troisiemetype/universal_AVR_programmer/components/ISP.ods

Id | Référence | Boîtier | Quantité | Désignation | face | fabricant | référence | fournisseur
21 | C1 | C_0603_1608Metric | 1 | 1u | top | samsung | CL10A105KP8NNWC (https://www.mouser.fr/ProductDetail/187-CL10A105KP8NNWC) | mouser
2 | C4,C2,C3 | C_0603_1608Metric | 3 | 0.1u | top | samsung | CL10B104KA8NNWC (https://www.mouser.fr/ProductDetail/187-CL10B104KA8NNWC) | mouser
10 | D1 | D_SOD-123 | 1 | D | top | OnSemi | MMSD4148T3G (https://www.mouser.fr/ProductDetail/863-MMSD4148T3G) | mouser
20 | D2 | D_SOD-123 | 1 | D_Schottky | top | Nexperia | BAT54GWJ (https://www.mouser.fr/ProductDetail/841-BAT54GWJ) | mouser
14 | D5,D3,D4 | LED_0805_2012Metric | 3 | LED | top | / | led rouge 0603 | aliexpress
24 | F1 | Fuse_1206_3216Metric | 1 | 500m | top | Bel Fuse | C1Q 500 (https://www.mouser.fr/ProductDetail/530-C1Q500) | mouser
13 | IC1 | SOT-5X3 | 1 | TPD2E1B06 | top | TI | TPD2E1B06DRLR (https://www.mouser.fr/ProductDetail/595-TPD2E1B06DRLR) | mouser
4 | J1 | Connector_pad_1x03_P2.54mm | 1 | plug board face | /
30 | J10 | Pin_Header_Straight_2x03_Pitch2.54mm_SMD | 1 | Board-ISP | /
17 | J11 | Connector_pad_1x03_L10_P2.54mm | 1 | ISP face 1 | /
32 | J12 | Connector_pad_1x03_L10_P2.54mm | 1 | ISP face 2 | /
19 | J13 | Connector_pad_1x06_L10_P1.27mm | 1 | micro ISP | /
1 | J14 | Connector_pad_1x03_L10_P1.27mm | 1 | ISP face 1 | /
29 | J15 | Connector_pad_1x03_L10_P1.27mm | 1 | ISP face 2 | /
31 | J2 | Connector_pad_1x03_P2.54mm | 1 | plug board pile | /
15 | J5 | Connector_pad_1x03_P2.54mm | 1 | plug micro ISP face | /
27 | J6 | Connector_pad_1x03_P2.54mm | 1 | plug micro ISP pile | /
3 | J7,J3 | Connector_pad_1x03_P2.54mm | 2 | plug 2x3 face | /
28 | J8,J4 | Connector_pad_1x03_P2.54mm | 2 | plug 2x3 pile | /
11 | J9 | USB_C_Receptacle_GCT_USB4085 | 1 | USB_C_Receptacle_USB2.0 | top | GCT | USB4085-GF-A (https://www.mouser.fr/ProductDetail/640-USB4085-GF-A) | mouser
33 | logo_labo_4mm | logo_labo_4mm | 1 | G*** | /
8 | Q2,Q1 | SOT-23 | 2 | Q_NMOS_GSD | top | Toshiba | T2N7002AK,LM (https://www.mouser.fr/ProductDetail/757-T2N7002AKLM) | mouser
23 | R1 | R_0603_1608Metric | 1 | 1M | top | Bourns | CR0603-FX-1004ELF (https://www.mouser.fr/ProductDetail/652-CR0603FX-1004ELF) | mouser
9 | R3,R2 | R_0603_1608Metric | 2 | 5.1k | top | Bourns | CR0603-FX-5101ELF (https://www.mouser.fr/ProductDetail/652-CR0603FX-5101ELF) | mouser
18 | R4 | R_0603_1608Metric | 1 | 10k | top | Bourns | CR0603-JW-103ELF (https://www.mouser.fr/ProductDetail/652-CR0603-JW-103ELF) | mouser
6 | R5,R6 | R_0603_1608Metric | 2 | 22R | top | Bourns | CR0603-JW-220ELF (https://www.mouser.fr/ProductDetail/652-CR0603-JW-220ELF) | mouser
26 | R7 | R_0603_1608Metric | 1 | 470R | top | Bourns | CR0603-JW-471ELF (https://www.mouser.fr/ProductDetail/652-CR0603JW-471ELF) | mouser
5 | R8,R10,R9 | R_0603_1608Metric | 3 | 680R | top | Bourns | CR0603-FX-6800ELF (https://www.mouser.fr/ProductDetail/652-CR0603FX-6800ELF) | mouser
7 | RN1 | R_Array_Convex_4x0603 | 1 | 10k | top | Panasonic | EXB-V8V103JV (https://www.mouser.fr/ProductDetail/667-EXB-V8V103JV) | mouser
12 | SW1 | SW_CuK_OS102011MA1QN1_SPDT_Angled | 1 | SW_SPDT | top | C&K switches | OS102011MA1QN1 (https://www.mouser.fr/ProductDetail/611-OS102011MA1QN1) | mouser
16 | SW2 | SW_SPST_EVPBF | 1 | SW_Push | top | Panasonic | EVP-BFAC1A000 (https://www.mouser.fr/ProductDetail/667-EVP-BFAC1A000) | mouser
22 | U1 | TQFP-32_7x7mm_P0.8mm | 1 | ATmega8U2-A | top | Microchip | ATMEGA8U2-AUR (https://www.mouser.fr/ProductDetail/556-ATMEGA8U2-AUR) | mouser
25 | Y1 | Resonator_SMD_Murata_CSTxExxV-3Pin_3.0x1.1mm_HandSoldering | 1 | Crystal_GND2 | top | Murata | CSTNE16M0V530000R0 (https://www.mouser.fr/ProductDetail/81-CSTNE16M0V530000R) | mouser
