troisiemetype/universal_AVR_programmer/pdf/ISP_schematics.pdf

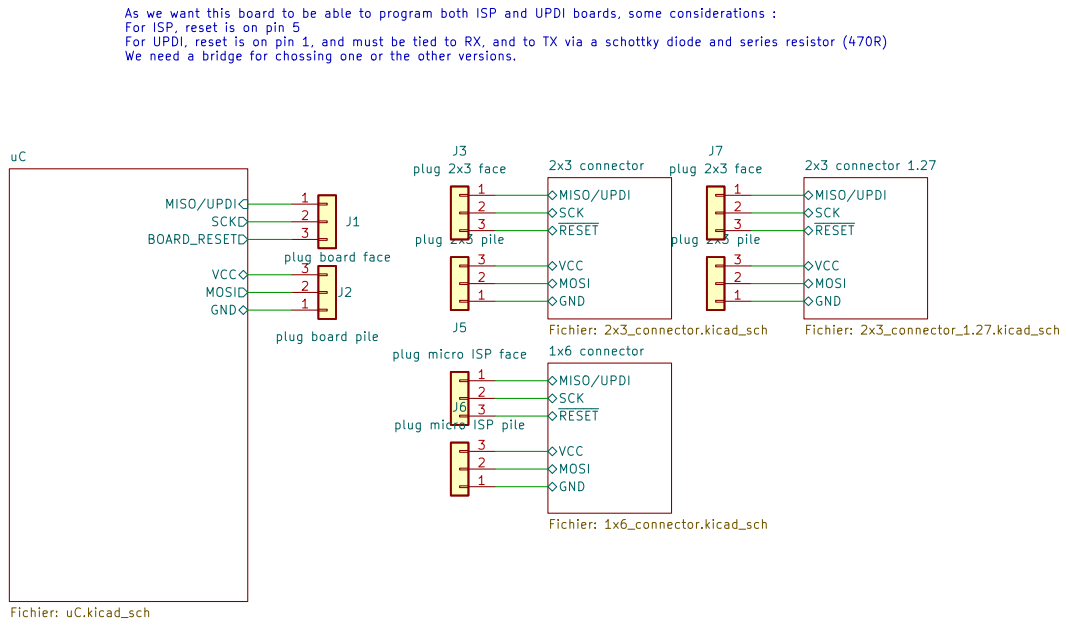
[picture p1: page 1]

As we want this board to be able to program both ISP and UPDI boards, some considerations :
For ISP, reset is on pin 5
For UPDI, reset is on pin 1, and must be tied to RX, and to TX via a schottky diode and series resistor (470R)
We need a bridge for chossing one or the other versions.

2x3 connector Fichier: 2x3_connector.kicad_sch MISO/UPDI SCK MOSI GND

2x3 connector 1.27 Fichier: 2x3_connector_1.27.kicad_sch ~{RESET} GND MOSI MISO/UPDI SCK

VCC MISO/UPDI SCK MOSI BOARD_RESET

~{RESET} GND MOSI MISO/UPDI SCK

~{RESET} 1x6 connector Fichier: 1x6_connector.kicad_sch GND

plug micro ISP face

plug micro ISP pile

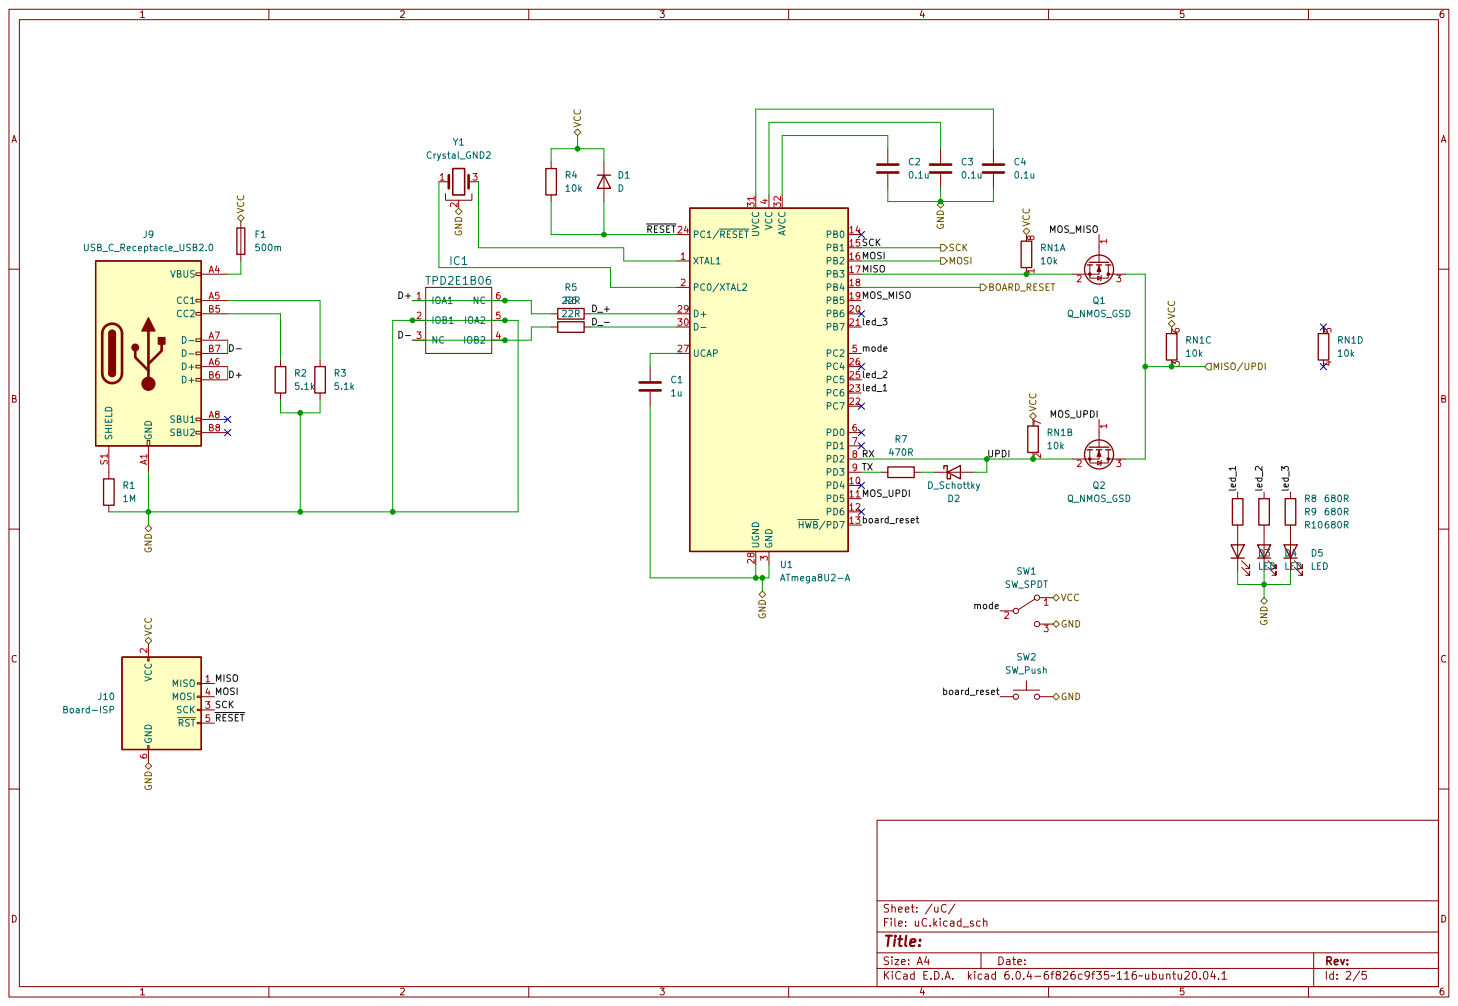
[picture p2: page 2]

2 SCK 3 MOSI 4 ~{RST} 5 GND

File: uC.kicad_sch Sheet: /uC/
Id: 2/5 Title:

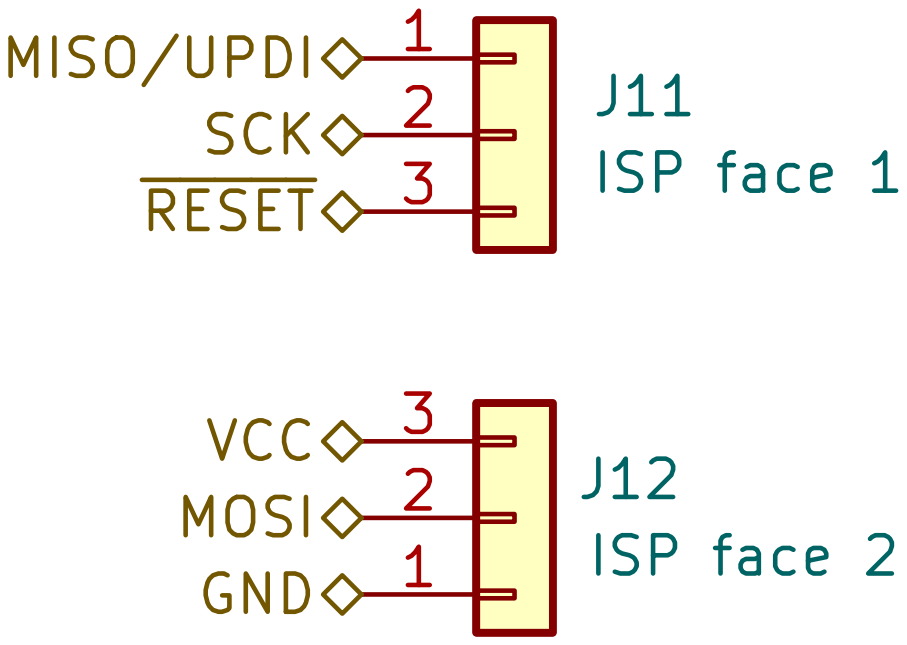
[picture p3: page 3]

ISP face 1 ~{RESET} GND MOSI MISO/UPDI SCK

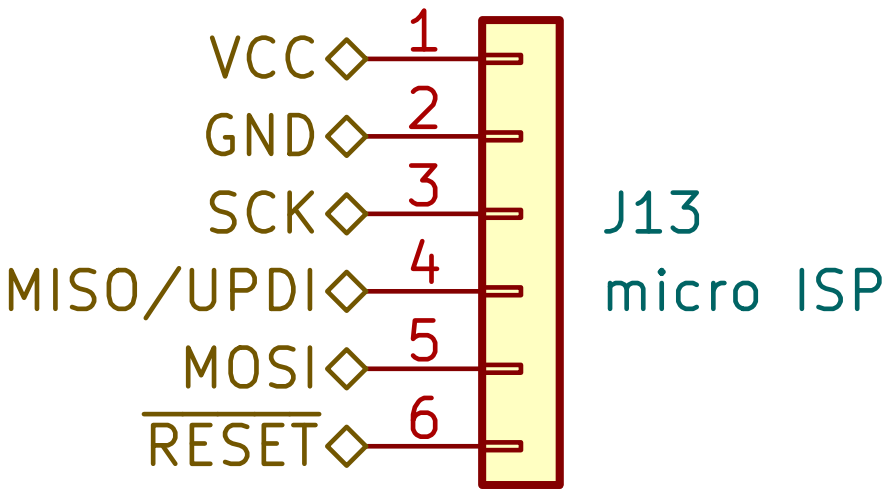
[picture p4: page 4]

VCC GND MISO/UPDI SCK

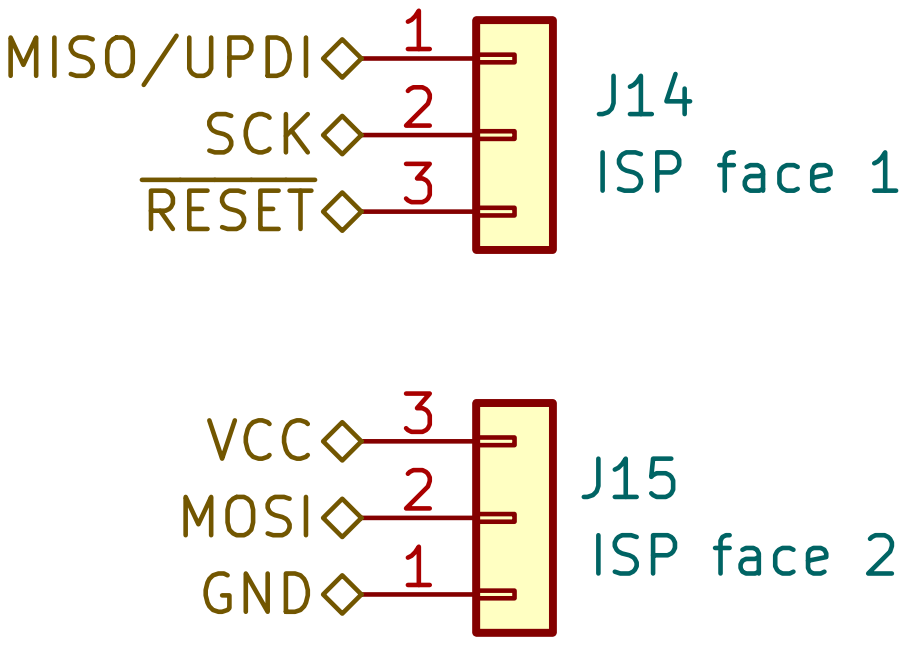
[picture p5: page 5]

ISP face 1 ~{RESET} GND MOSI MISO/UPDI SCK
