troisiemetype/universal_AVR_programmer/ISP.kicad_pcb

## KiCad design ISP.kicad_pcb (2022-03-06)

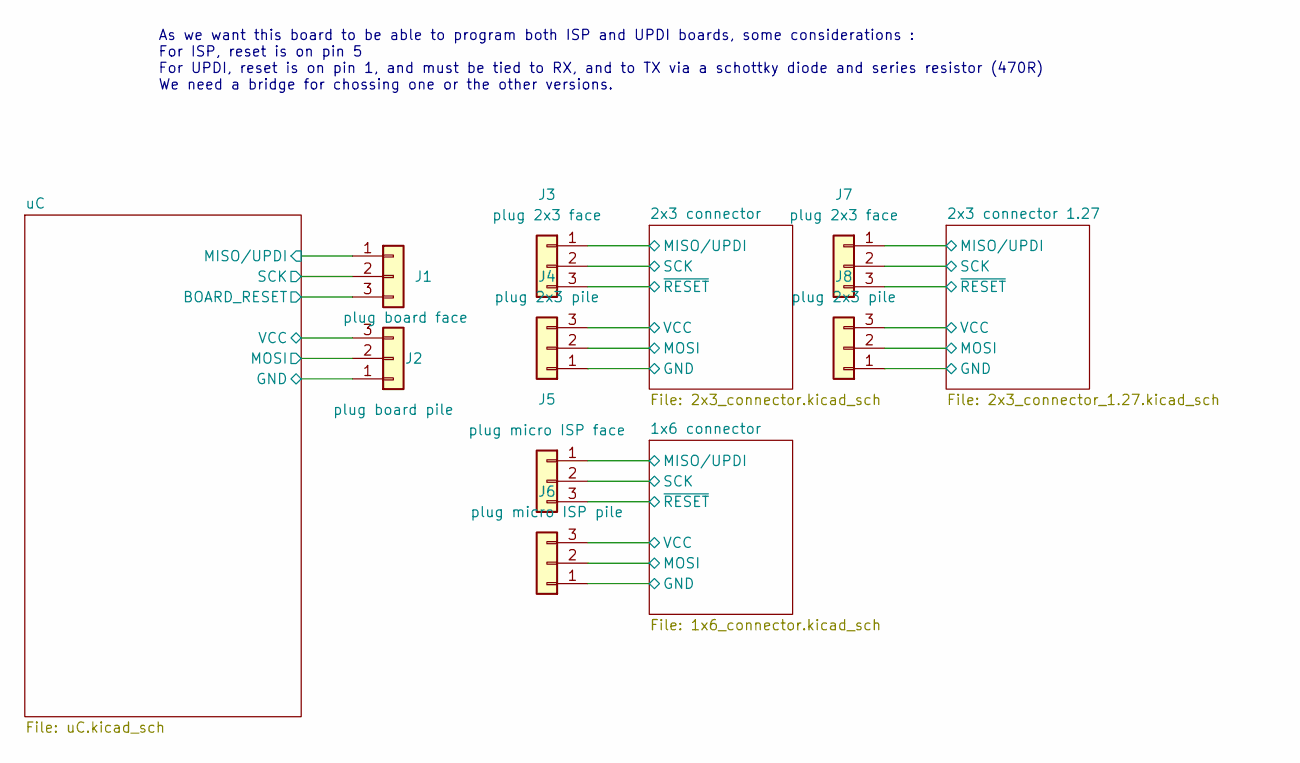
[picture p6: schematic ISP.kicad_sch]

Parts:
J1: plug board face; Connector_pad_1x03_P2.54mm
J2: plug board pile; Connector_pad_1x03_P2.54mm
J3, J7: plug 2x3 face; Connector_pad_1x03_P2.54mm
J4, J8: plug 2x3 pile; Connector_pad_1x03_P2.54mm
J5: plug micro ISP face; Connector_pad_1x03_P2.54mm
J6: plug micro ISP pile; Connector_pad_1x03_P2.54mm

Connections:
/1x6 connector/GND: J6.1; also elsewhere on the board
/1x6 connector/MISO/UPDI: J5.1; also elsewhere on the board
/1x6 connector/MOSI: J6.2; also elsewhere on the board
/1x6 connector/SCK: J5.2; also elsewhere on the board
/1x6 connector/VCC: J6.3; also elsewhere on the board
/1x6 connector/~RESET: J5.3; also elsewhere on the board
/2x3 connector 1.27/GND: J8.1; also elsewhere on the board
/2x3 connector 1.27/MISO/UPDI: J7.1; also elsewhere on the board
/2x3 connector 1.27/MOSI: J8.2; also elsewhere on the board
/2x3 connector 1.27/SCK: J7.2; also elsewhere on the board
/2x3 connector 1.27/VCC: J8.3; also elsewhere on the board
/2x3 connector 1.27/~RESET: J7.3; also elsewhere on the board
/2x3 connector/GND: J4.1; also elsewhere on the board
/2x3 connector/MISO/UPDI: J3.1; also elsewhere on the board
/2x3 connector/MOSI: J4.2; also elsewhere on the board
/2x3 connector/SCK: J3.2; also elsewhere on the board
/2x3 connector/VCC: J4.3; also elsewhere on the board
/2x3 connector/~RESET: J3.3; also elsewhere on the board
/uC/BOARD_RESET: J1.3; also elsewhere on the board
/uC/GND: J2.1; also elsewhere on the board
/uC/MISO/UPDI: J1.1; also elsewhere on the board
/uC/MOSI: J2.2; also elsewhere on the board
/uC/SCK: J1.2; also elsewhere on the board
/uC/VCC: J2.3; also elsewhere on the board

Notes on the sheet:
As we want this board to be able to program both ISP and UPDI boards, some considerations : For ISP, reset is on pin 5 For UPDI, reset is on pin 1, and must be tied to RX, and to TX via a schottky diode and series resistor (470R) We need a bridge for chossing one or the other versions.

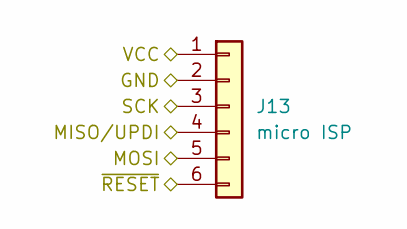
[picture p7: schematic 1x6_connector.kicad_sch]

Parts:
J13: micro ISP; Connector_pad_1x06_L10_P1.27mm

Connections:
/1x6 connector/GND: J13.2; also elsewhere on the board
/1x6 connector/MISO/UPDI: J13.4; also elsewhere on the board
/1x6 connector/MOSI: J13.5; also elsewhere on the board
/1x6 connector/SCK: J13.3; also elsewhere on the board
/1x6 connector/VCC: J13.1; also elsewhere on the board
/1x6 connector/~RESET: J13.6; also elsewhere on the board

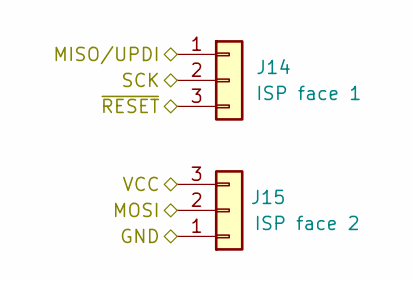
[picture p8: schematic 2x3_connector_1.27.kicad_sch]

Parts:
J14: ISP face 1; Connector_pad_1x03_L10_P1.27mm
J15: ISP face 2; Connector_pad_1x03_L10_P1.27mm

Connections:
/2x3 connector 1.27/GND: J15.1; also elsewhere on the board
/2x3 connector 1.27/MISO/UPDI: J14.1; also elsewhere on the board
/2x3 connector 1.27/MOSI: J15.2; also elsewhere on the board
/2x3 connector 1.27/SCK: J14.2; also elsewhere on the board
/2x3 connector 1.27/VCC: J15.3; also elsewhere on the board
/2x3 connector 1.27/~RESET: J14.3; also elsewhere on the board

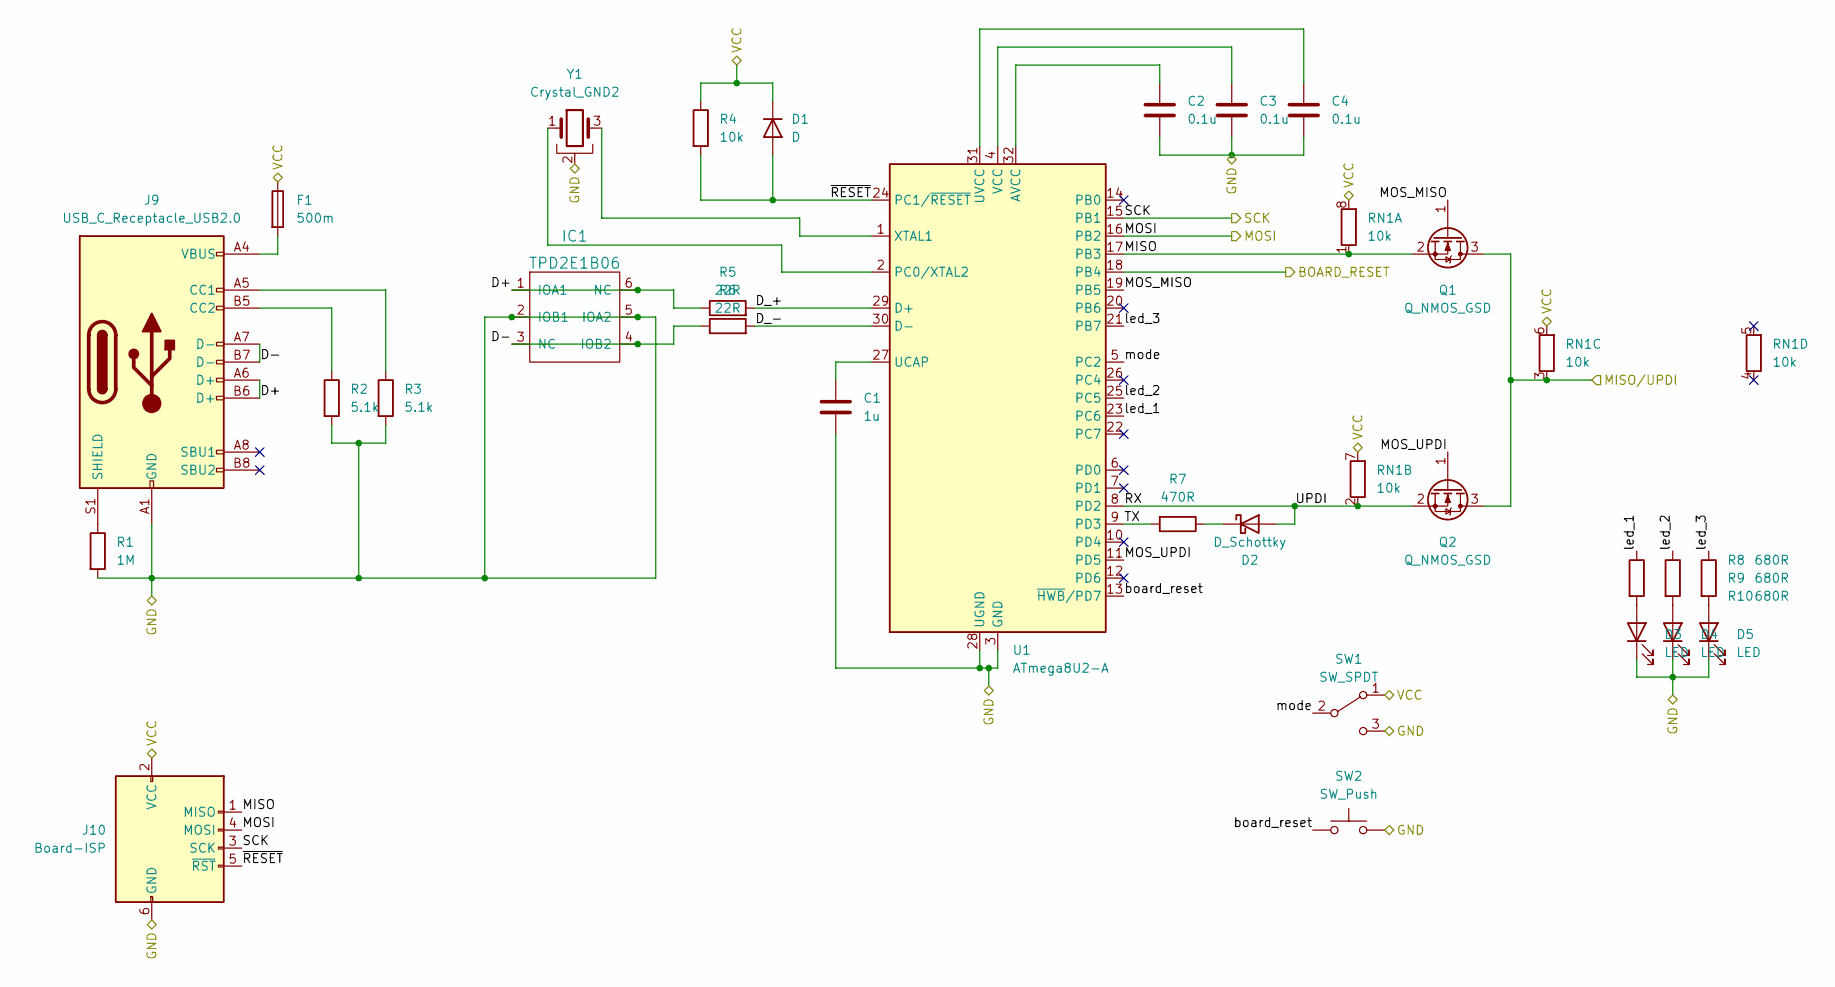
[picture p9: schematic uC.kicad_sch]

Parts:
C1: 1u; C_0603_1608Metric
C2, C3, C4: 0.1u; C_0603_1608Metric
D1: D; D_SOD-123
D2: D_Schottky; D_SOD-123
D3, D4, D5: LED; LED_0805_2012Metric
F1: 500m; Fuse_1206_3216Metric
IC1: TPD2E1B06; SOT-5X3
J9: USB_C_Receptacle_USB2.0; USB_C_Receptacle_GCT_USB4085
J10: Board-ISP; Pin_Header_Straight_2x03_Pitch2.54mm_SMD
Q1, Q2: Q_NMOS_GSD; SOT-23
R1: 1M; R_0603_1608Metric
R2, R3: 5.1k; R_0603_1608Metric
R4: 10k; R_0603_1608Metric
R5, R6: 22R; R_0603_1608Metric
R7: 470R; R_0603_1608Metric
R8, R9, R10: 680R; R_0603_1608Metric
RN1: 10k; R_Array_Convex_4x0603
SW1: SW_SPDT; SW_CuK_OS102011MA1QN1_SPDT_Angled
SW2: SW_Push; SW_SPST_EVPBF
U1: ATmega8U2-A; TQFP-32_7x7mm_P0.8mm
Y1: Crystal_GND2; Resonator_SMD_Murata_CSTxExxV-3Pin_3.0x1.1mm_HandSoldering

Connections:
/uC/BOARD_RESET: U1.18 (PB4); also elsewhere on the board
/uC/D+: IC1.1 (IOA1), IC1.6 (NC), J9.A6 (D+), J9.B6 (D+), R5.1
/uC/D-: IC1.3 (NC), IC1.4 (IOB2), J9.A7 (D-), J9.B7 (D-), R6.1
/uC/D_+: R5.2, U1.29 (D+)
/uC/D_-: R6.2, U1.30 (D-)
/uC/GND: C1.2, C2.2, C3.2, C4.2, D3.1 (K), D4.1 (K), D5.1 (K), IC1.2 (IOB1), IC1.5 (IOA2), J9.A1 (GND), J9.A12 (GND), J9.B1 (GND), J9.B12 (GND), J10.6 (GND), R1.2, R2.2, R3.2, SW1.3 (C), SW2.2, U1.3 (GND), U1.28 (UGND), Y1.2; also elsewhere on the board
/uC/MISO: J10.1 (MISO), Q1.2 (S), RN1.1 (R1.1), U1.17 (PB3)
/uC/MISO/UPDI: Q1.3 (D), Q2.3 (D), RN1.3 (R3.1); also elsewhere on the board
/uC/MOSI: J10.4 (MOSI), U1.16 (PB2); also elsewhere on the board
/uC/MOS_MISO: Q1.1 (G), U1.19 (PB5)
/uC/MOS_UPDI: Q2.1 (G), U1.11 (PD5)
/uC/RX: D2.2 (A), Q2.2 (S), RN1.2 (R2.1), U1.8 (PD2)
/uC/SCK: J10.3 (SCK), U1.15 (PB1); also elsewhere on the board
/uC/TX: R7.2, U1.9 (PD3)
/uC/VCC: D1.1 (K), F1.1, J10.2 (VCC), R4.1, RN1.6 (R3.2), RN1.7 (R2.2), RN1.8 (R1.2), SW1.1 (A); also elsewhere on the board
/uC/board_reset: SW2.1, U1.13 (~HWB/PD7)
/uC/led_1: R8.1, U1.23 (PC6)
/uC/led_2: R9.1, U1.25 (PC5)
/uC/led_3: R10.1, U1.21 (PB7)
/uC/mode: SW1.2 (B), U1.5 (PC2)
/uC/~RESET: D1.2 (A), J10.5 (~RST), R4.2, U1.24 (PC1/~RESET)
unnamed: C1.1, U1.27 (UCAP)
unnamed: C2.1, U1.32 (AVCC)
unnamed: C3.1, U1.4 (VCC)
unnamed: C4.1, U1.31 (UVCC)
unnamed: D2.1 (K), R7.1
unnamed: D3.2 (A), R8.2
unnamed: D4.2 (A), R9.2
unnamed: D5.2 (A), R10.2
unnamed: F1.2, J9.A4 (VBUS), J9.A9 (VBUS), J9.B4 (VBUS), J9.B9 (VBUS)
unnamed: J9.A5 (CC1), R3.1
unnamed: J9.B5 (CC2), R2.1
unnamed: J9.S1 (SHIELD), R1.1
unnamed: U1.1 (XTAL1), Y1.3
unnamed: U1.2 (PC0/XTAL2), Y1.1

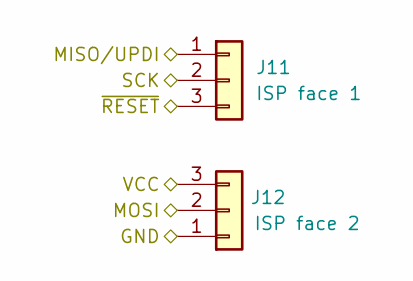
[picture p10: schematic 2x3_connector.kicad_sch]

Parts:
J11: ISP face 1; Connector_pad_1x03_L10_P2.54mm
J12: ISP face 2; Connector_pad_1x03_L10_P2.54mm

Connections:
/2x3 connector/GND: J12.1; also elsewhere on the board
/2x3 connector/MISO/UPDI: J11.1; also elsewhere on the board
/2x3 connector/MOSI: J12.2; also elsewhere on the board
/2x3 connector/SCK: J11.2; also elsewhere on the board
/2x3 connector/VCC: J12.3; also elsewhere on the board
/2x3 connector/~RESET: J11.3; also elsewhere on the board

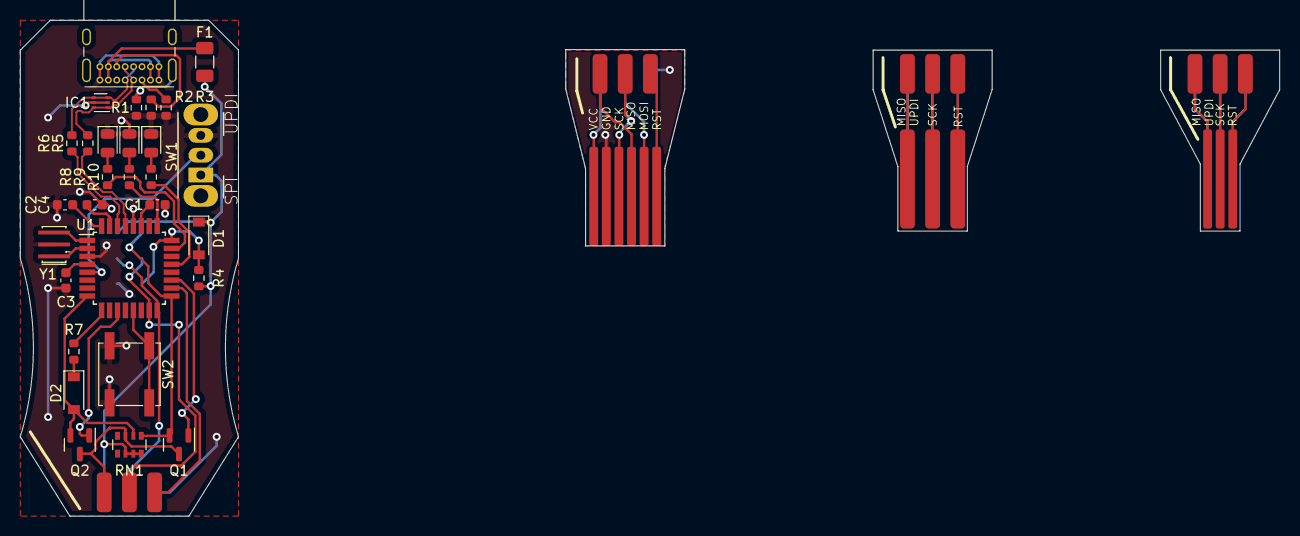
[picture p11: board ISP.kicad_pcb from above]

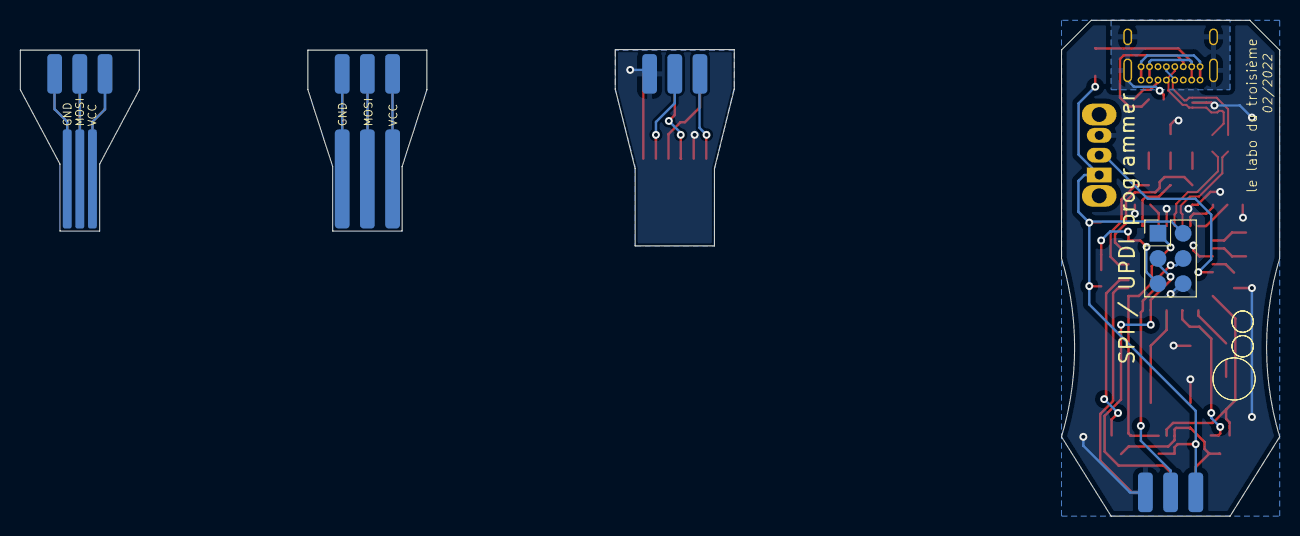
[picture p12: board ISP.kicad_pcb from below]

Board: 2 copper layers, 127.0 x 50.0 mm, 44 parts (8 on the bottom side), 53 nets.

Other parts of the board:
logo_labo_4mm: G***; logo_labo_4mm
