troisiemetype/universal_AVR_programmer/misc/How to have a board not work.jpg

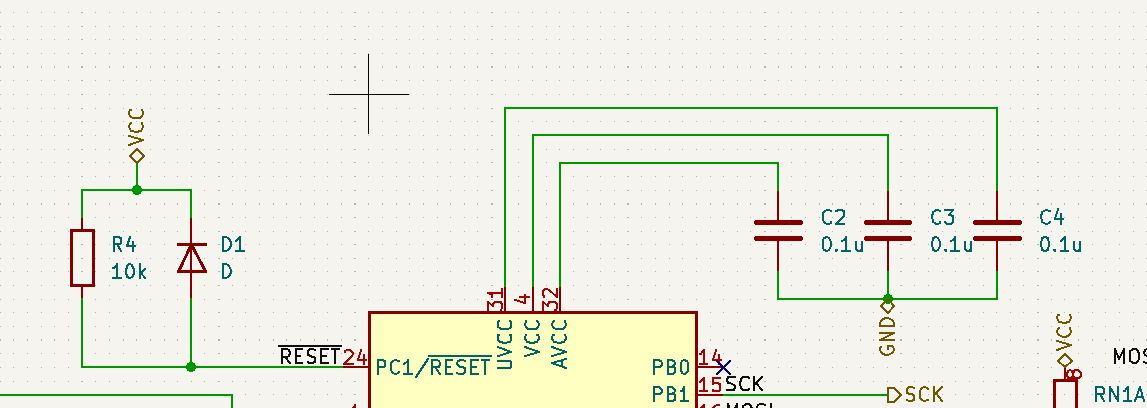
misc/How to have a board not work.jpg
