troisiemetype/universal_AVR_programmer/(commit log)

2022-03-06 Initial commit. v1.0 sent to fab.
    [1x6_connector.kicad_sch, 2x3_connector.kicad_sch, 2x3_connector_1.27.kicad_sch, ISP.kicad_pcb, ISP.kicad_sch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]
2022-03-29 Added components list. Added notes about modifications to be made on the next version. Added a beautiful example of how a board can be made to need bodging.
    [ISP.csv, ISP.ods]
2022-03-29 Added schematics.
